eherrpic-lgtm/macropad-v2/README.md

A small macropod featuring 12 programmable keys and 2 rotary encoders. Uses a sandwich design to hold down the pcb and 12 mx switches with a top black plate. 
Keys are programmed to optimise coding and make it easier to access things that can be on the harder side of things to do with a normal keyboard, offering quickly accessible shortcuts for key functions

**Materials for 2 macropads** *add 1 microcontroller and 2 rotary encoders and 2 encoder knobs for 1 more*

| Item | Qty | Description | Vendor | Est. Price
| :--- | :---: | :--- | :--- | :---: |
| Custom PCB | 5 | 2-Layer Macropad PCB | JLCPCB | €1.76 |
| Top Plate | 5 | 1.6mm top plate | JLCPCB | €6.49 |
| Microcontroller | 2 | MOUDLE-SEEDUINO-XIAO | [AliExpress](https://de.aliexpress.com/item/1005008200917480.html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) | €9.39 |
| Switches | 50 | Cherry MX-style mechanical switches | [AliExpress](https://de.aliexpress.com/item/1005012075309061.html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) | €13.99 |
| Rotary Encoders | 4 | EC11 Encoders | [AliExpress](https://de.aliexpress.com/item/1005007644083514.html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) | €3.12 |
| Diodes | 100 | 1N4148 Diodes | [AliExpress](https://de.aliexpress.com/item/1005008905065392.html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) | €1.25 |
| Keycaps & Knobs | 44 | 40x 1u Keycaps + 4x Encoder Knobs | [AliExpress](https://de.aliexpress.com/item/1005007572331245.html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), [AliExpress](https://de.aliexpress.com/item/1005007969022294.html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) | €17.1 |
| Case Hardware | 8 | M2 Brass Standoffs + M2 Screws | [AliExpress](https://de.aliexpress.com/item/1005008512900059.html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), [AliExpress](https://www.aliexpress.com/p/shoppingcart/index.html?spm=a2g0o.home.header.1.32097a8bodTR2p), [AliExpress](https://de.aliexpress.com/item/4000314663724.html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) | €6.37 |
| **Total Estimated Cost** | | *(Excluding Shipping)* | | **59.74** |
| **Shipping costs** | | | | |
| AliExpress | | | AliExpress | €8.68 |
| JLCPCB | | | JLCPCB | €10.61 |
 | **Final Estimated Cost** | | | | **€79.03** |

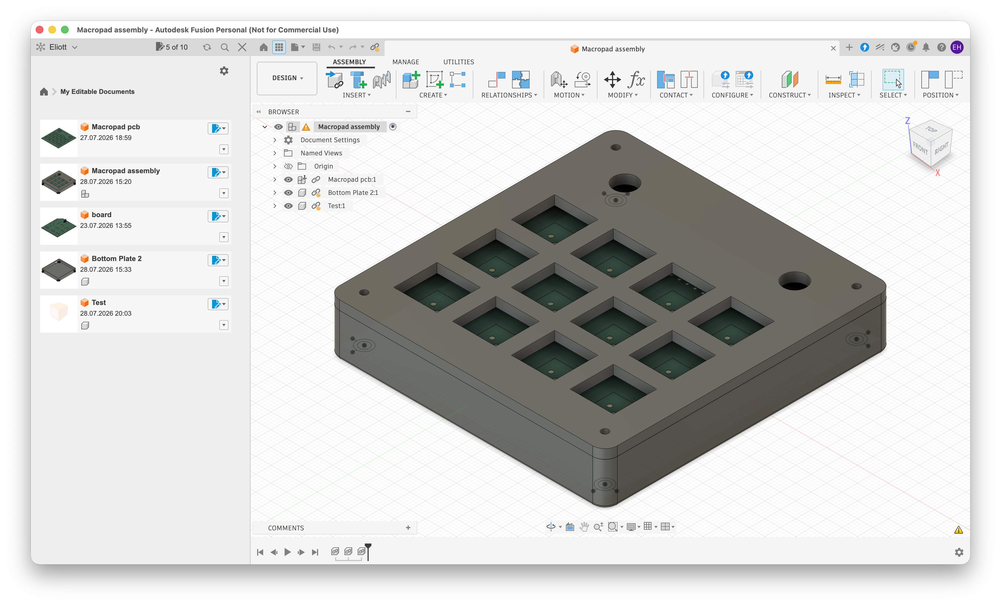
[picture p1: images/Assembly0.png]
3D Render

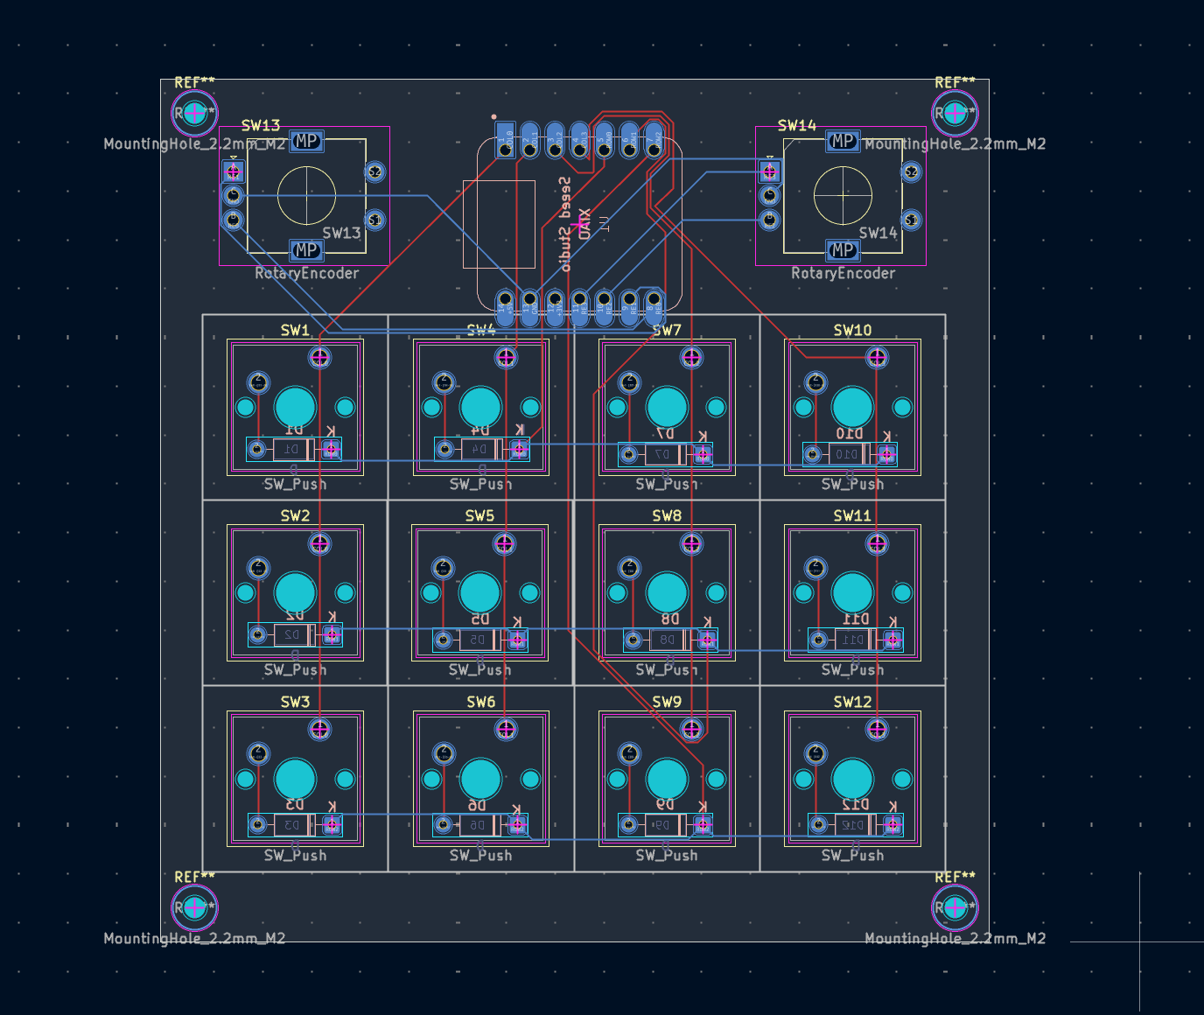
[picture p2: images/PCB.png]
PCB

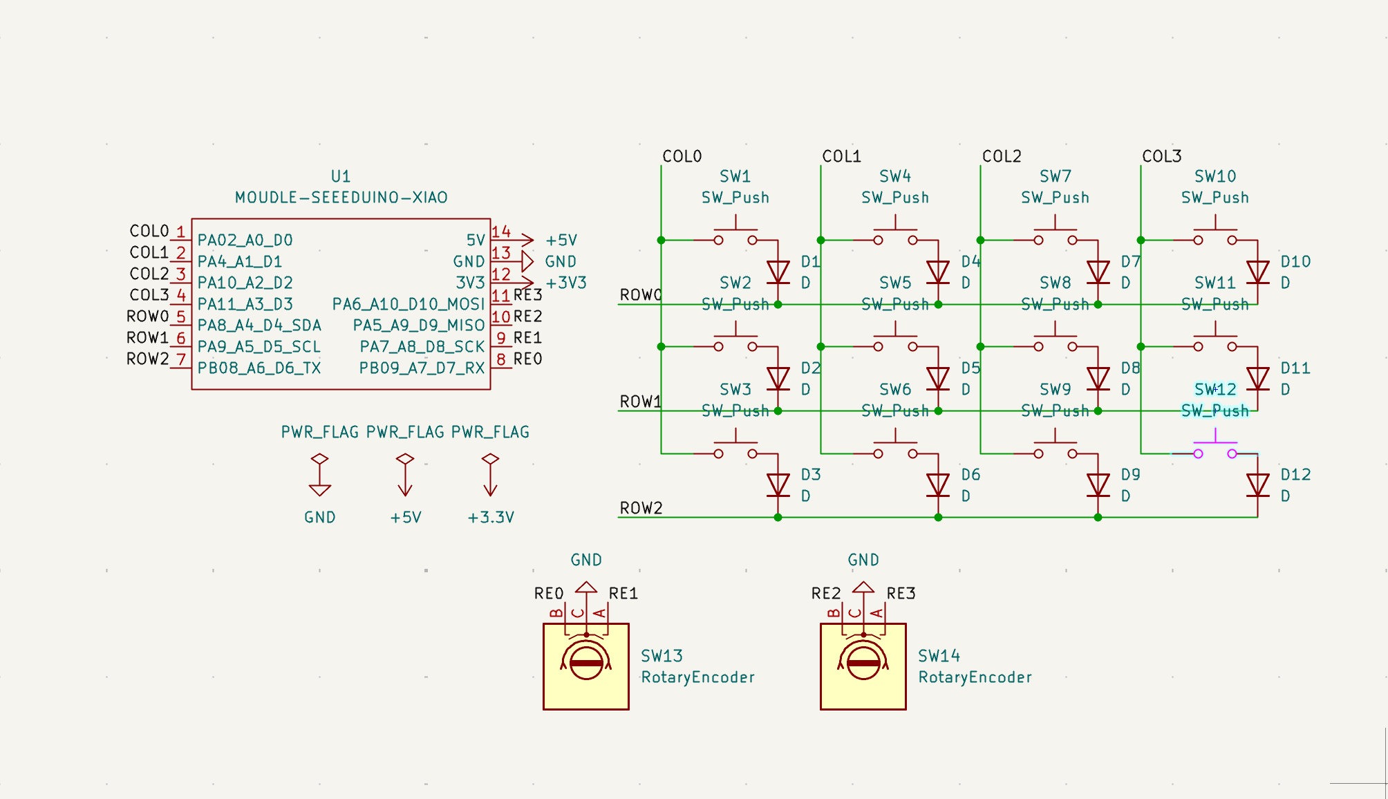
[picture p3: images/Schematic.png]
Schematic
