eherrpic-lgtm/macropad-v2/images/AliExpress.png

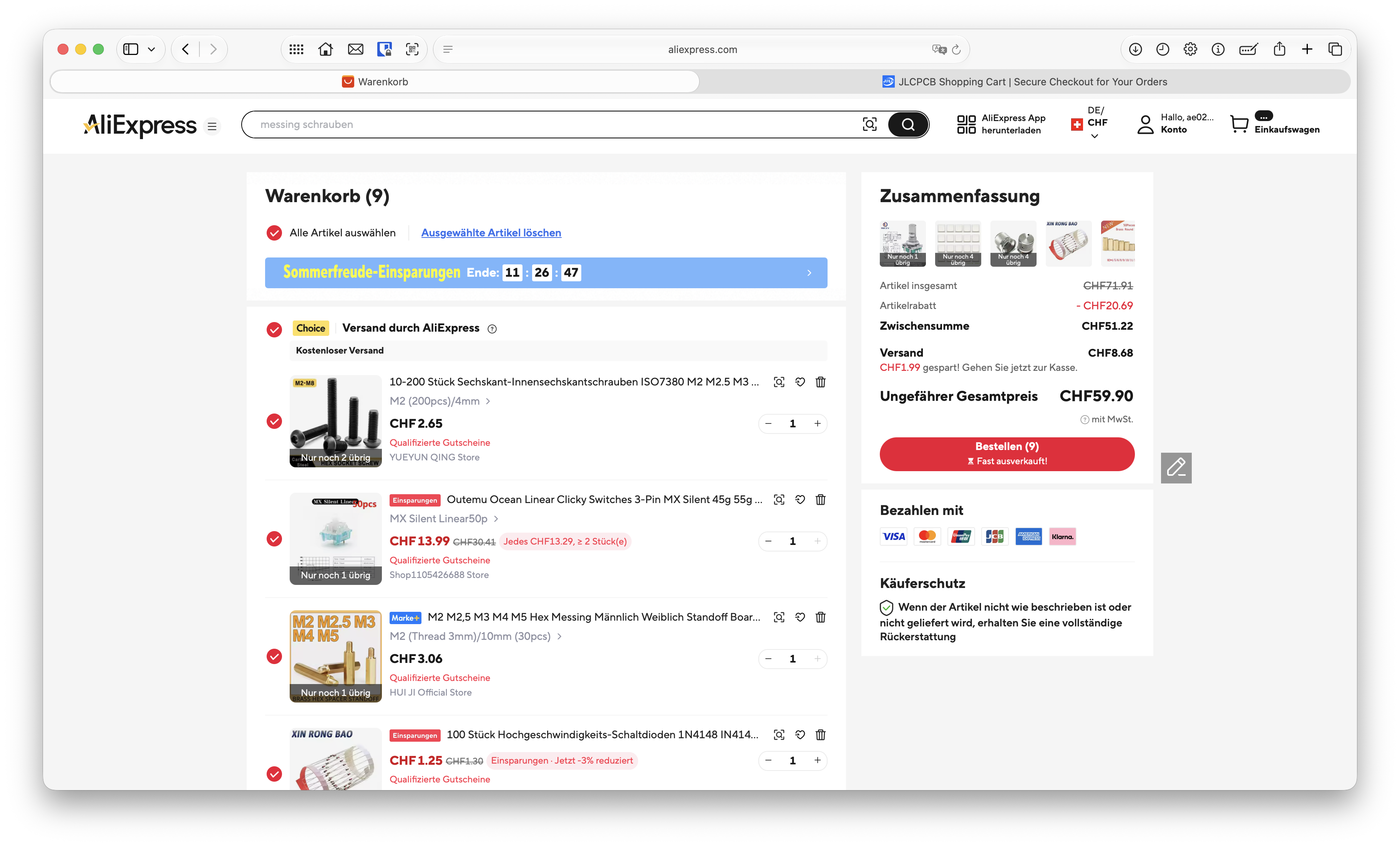
images/AliExpress.png
