eherrpic-lgtm/macropad-v2/images/JLCPCB.png

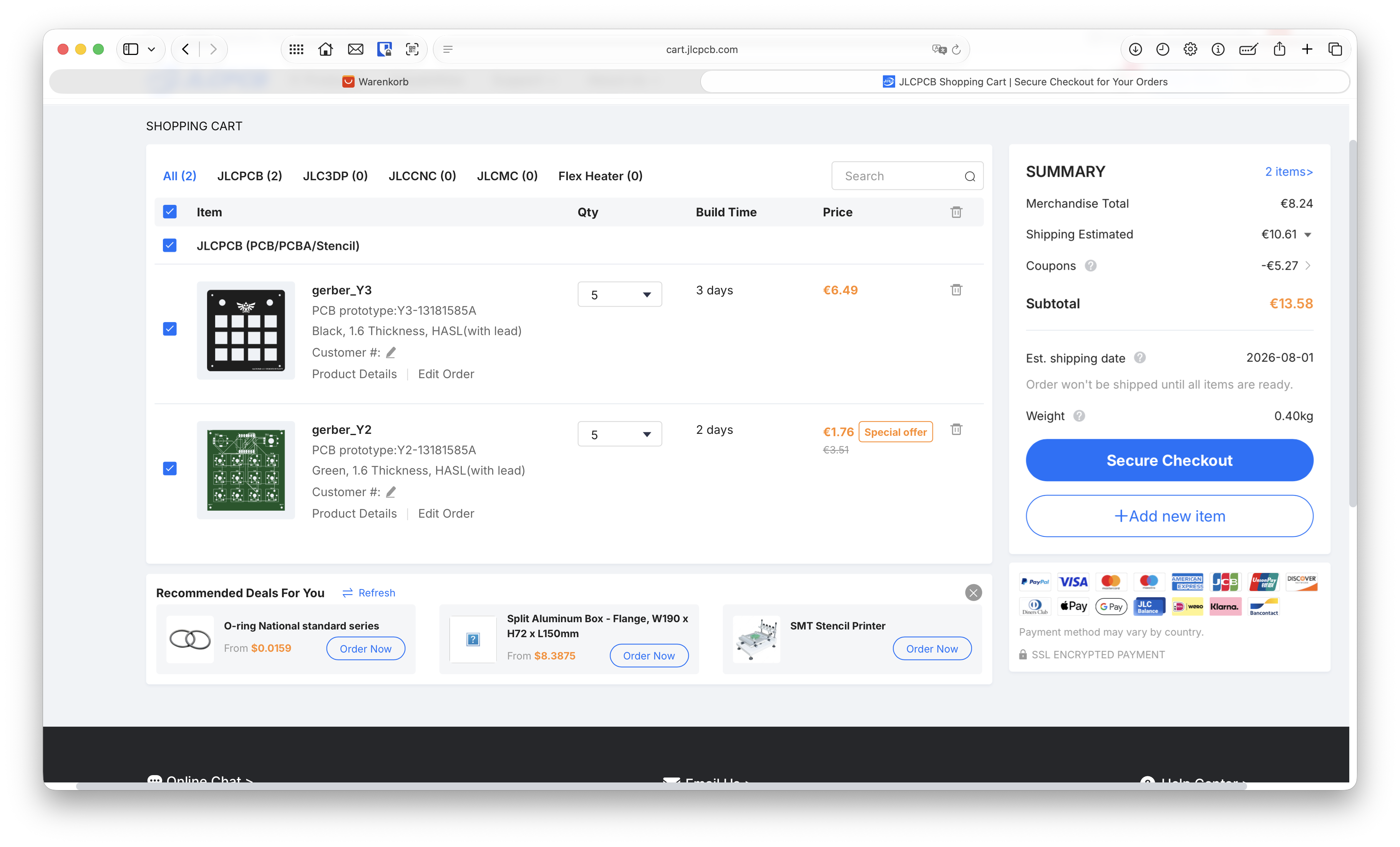
images/JLCPCB.png
