eherrpic-lgtm/macropad-v2/bom.csv

Reference | Qty | Value | DNP | Exclude from BOM | Exclude from Board | Footprint | Datasheet | Description
D1,D2,D3,D4,D5,D6,D7,D8,D9,D10,D11,D12 | 12 | D |  |  |  | Diode_THT:D_DO-35_SOD27_P7.62mm_Horizontal |  | Diode
SW1,SW2,SW3,SW4,SW5,SW6,SW7,SW8,SW9,SW10,SW11,SW12 | 12 | SW_Push |  |  |  | Button_Switch_Keyboard:SW_Cherry_MX_1.00u_PCB |  | Push button switch, generic, two pins
SW13,SW14 | 2 | RotaryEncoder |  |  |  | Rotary_Encoder:RotaryEncoder_Alps_EC11E-Switch_Vertical_H20mm |  | Rotary encoder, dual channel, incremental quadrate outputs
U1 | 1 | MOUDLE-SEEEDUINO-XIAO |  |  |  | footprints:XIAO-Generic-Hybrid-14P-2.54-21X17.8MM
