eherrpic-lgtm/macropad-v2/images/BOM AliExpress.png

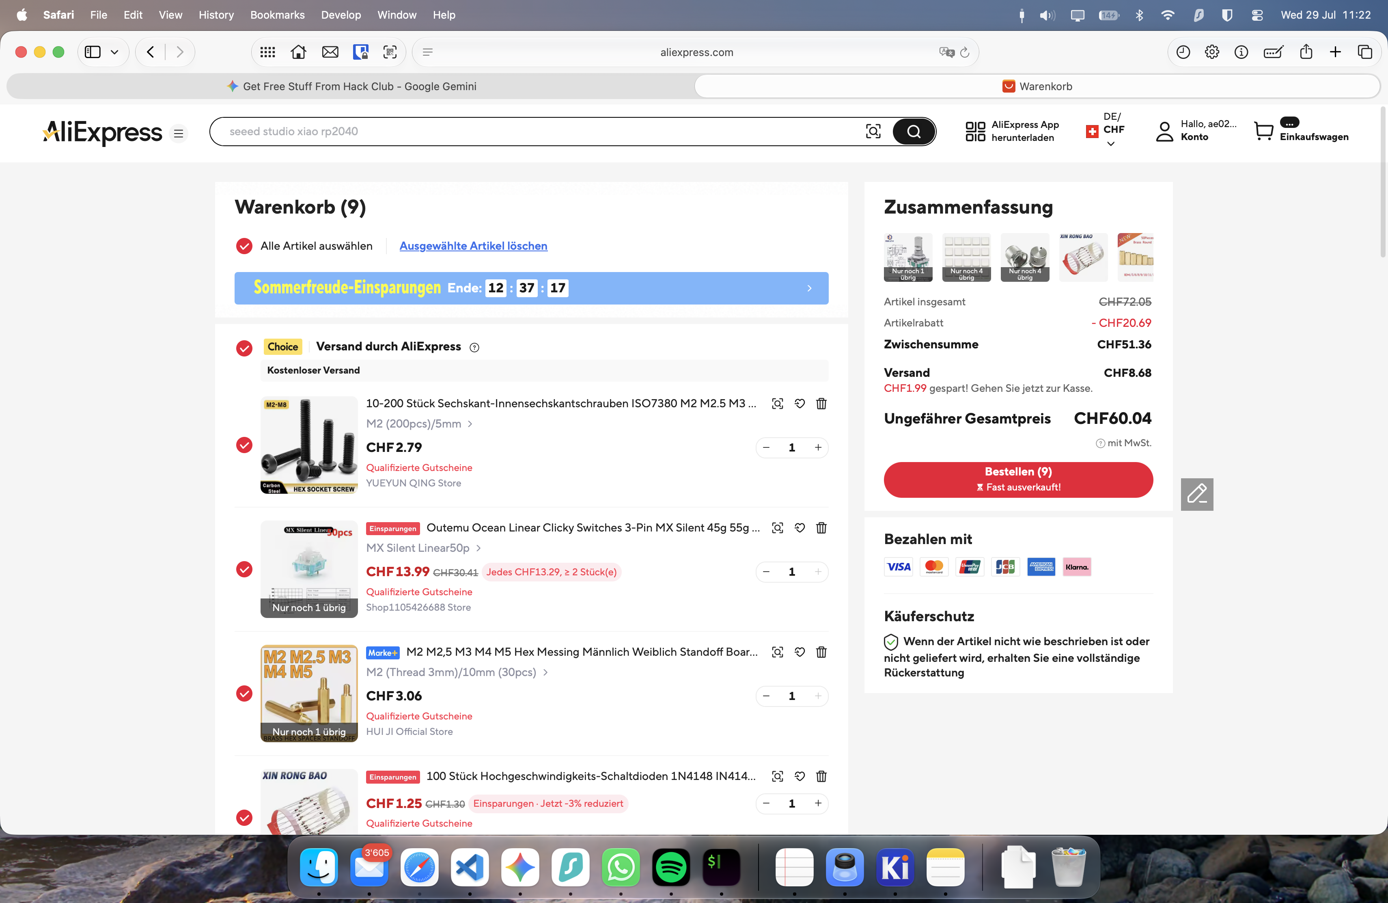
images/BOM AliExpress.png
