eherrpic-lgtm/macropad-v2/CAD/Macropad assembly.step

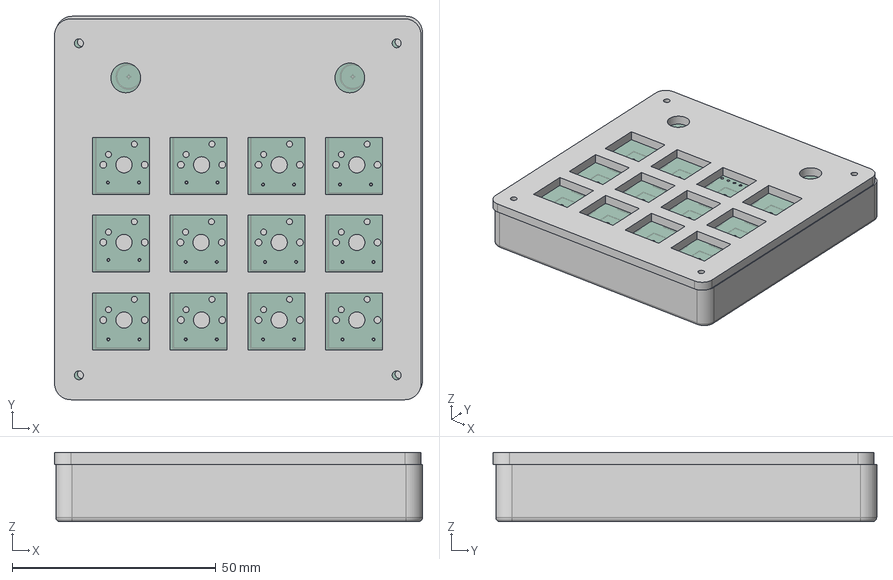
[picture p7: CAD file, 2026-11-11]
CAD/Macropad assembly.step
90.3 x 94.1 x 17.0 mm
D_DO-35_SOD27_P7.62mm_Horizontal_1 x 12
Macropad 2.0_silkscreen
Macropad 2.0_silkscreen_1
Macropad 2.0_soldermask
Macropad 2.0_soldermask_1
Macropad 2.0_PCB
