eherrpic-lgtm/macropad-v2/CAD/Top Plate PCB/Top Plate.dxf

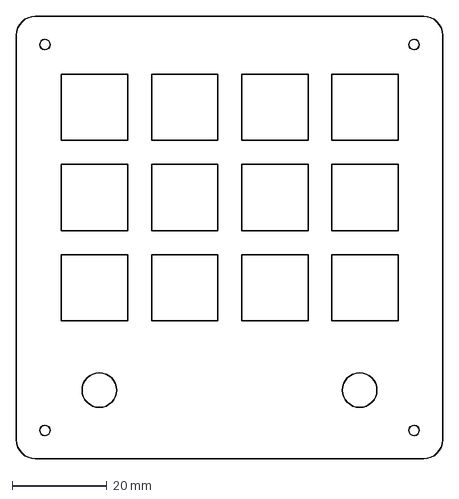
[picture p8: CAD file, 2026-07-28]
CAD/Top Plate PCB/Top Plate.dxf
90.0 x 93.5 mm
