eherrpic-lgtm/macropad-v2/CAD/Macropad pcb.step

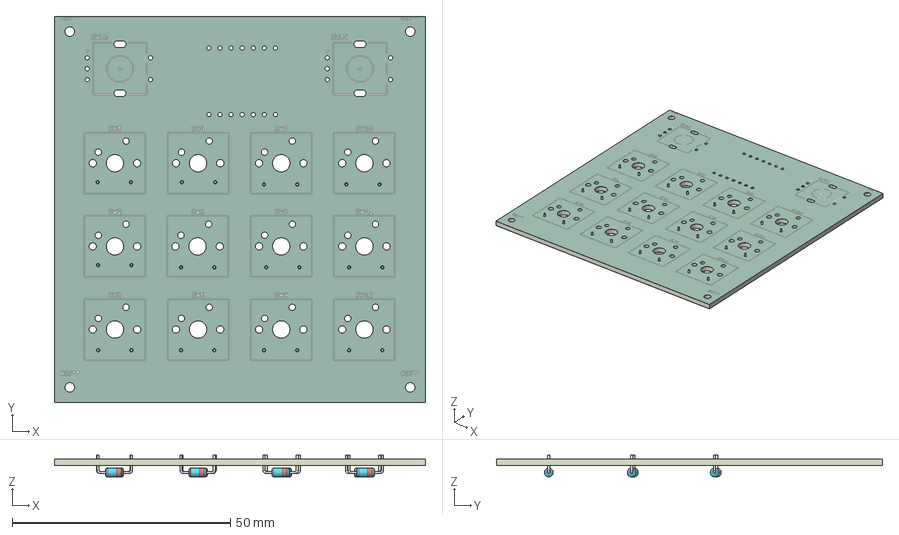
[picture p9: CAD file, 2026-11-11]
CAD/Macropad pcb.step
85.0 x 88.5 x 5.01 mm
D_DO-35_SOD27_P7.62mm_Horizontal_1 x 12
Macropad 2.0_silkscreen
Macropad 2.0_silkscreen_1
Macropad 2.0_soldermask
Macropad 2.0_soldermask_1
Macropad 2.0_PCB
