eherrpic-lgtm/macropad-v2/CAD/Bottom Plate.step

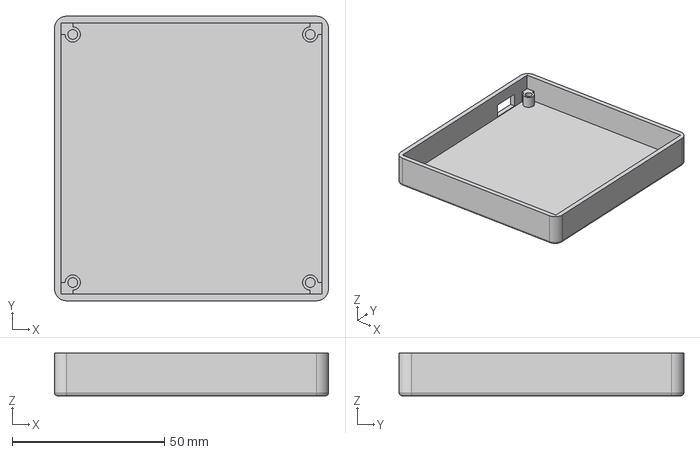
[picture p10: CAD file, 2026-07-28]
CAD/Bottom Plate.step
90.0 x 93.5 x 14.0 mm
