eherrpic-lgtm/macropad-v2/CAD/Top Plate.step

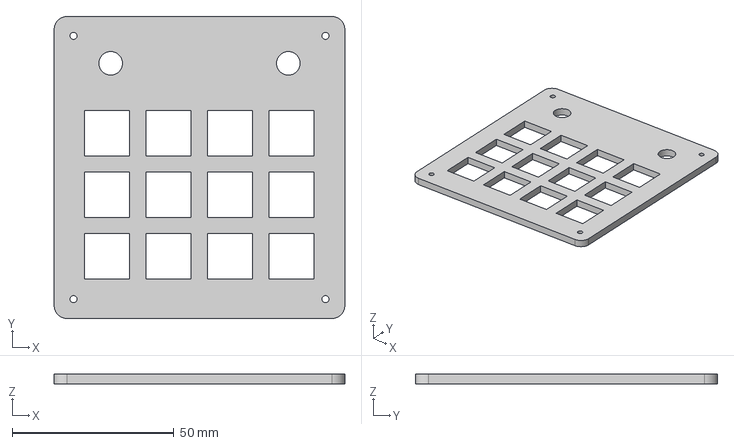
[picture p11: CAD file, 2026-07-28]
CAD/Top Plate.step
90.0 x 93.5 x 3.00 mm
