eherrpic-lgtm/macropad-v2/(list of files, cad)

Other CAD files:
CAD/Bottom Plate 2.f3d
CAD/Bottom Plate.stl
CAD/Macropad pcb.f3d
CAD/Top Plate.f3d
CAD/Top Plate.stl
