eherrpic-lgtm/macropad-v2/PCB/Macropad 2.0.kicad_pcb

## KiCad design PCB/Macropad 2.0.kicad_pcb (2026-07-28)

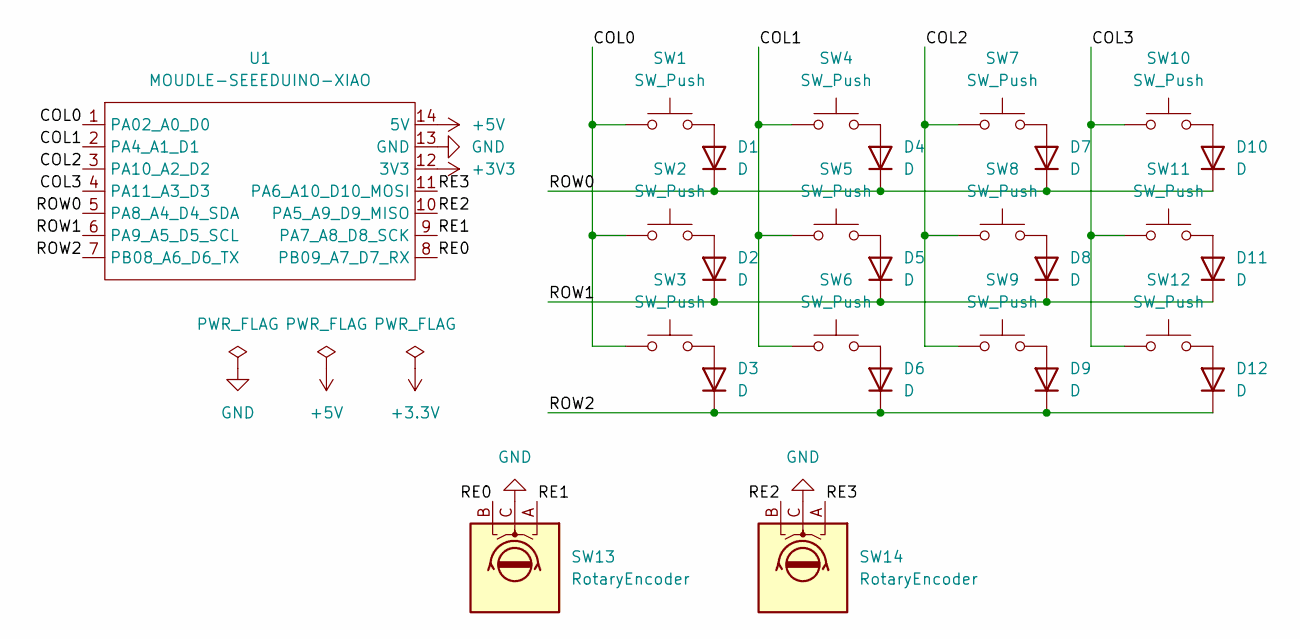
[picture p12: schematic Macropad 2.0.kicad_sch]

Parts:
D1, D2, D3, D4, D5, D6, D7, D8, D9, D10, D11, D12: D; D_DO-35_SOD27_P7.62mm_Horizontal
SW1, SW2, SW3, SW4, SW5, SW6, SW7, SW8, SW9, SW10, SW11, SW12: SW_Push; SW_Cherry_MX_1.00u_PCB
SW13, SW14: RotaryEncoder; RotaryEncoder_Alps_EC11E-Switch_Vertical_H20mm
U1: MOUDLE-SEEEDUINO-XIAO; XIAO-Generic-Hybrid-14P-2.54-21X17.8MM

Connections:
+3V3: U1.12 (3V3)
+5V: U1.14 (5V)
/COL0: SW1.1, SW2.1, SW3.1, U1.1 (PA02_A0_D0)
/COL1: SW4.1, SW5.1, SW6.1, U1.2 (PA4_A1_D1)
/COL2: SW7.1, SW8.1, SW9.1, U1.3 (PA10_A2_D2)
/COL3: SW10.1, SW11.1, SW12.1, U1.4 (PA11_A3_D3)
/RE0: SW13.B, U1.8 (PB09_A7_D7_RX)
/RE1: SW13.A, U1.9 (PA7_A8_D8_SCK)
/RE2: SW14.B, U1.10 (PA5_A9_D9_MISO)
/RE3: SW14.A, U1.11 (PA6_A10_D10_MOSI)
/ROW0: D1.1 (K), D4.1 (K), D7.1 (K), D10.1 (K), U1.5 (PA8_A4_D4_SDA)
/ROW1: D2.1 (K), D5.1 (K), D8.1 (K), D11.1 (K), U1.6 (PA9_A5_D5_SCL)
/ROW2: D3.1 (K), D6.1 (K), D9.1 (K), D12.1 (K), U1.7 (PB08_A6_D6_TX)
GND: SW13.C, SW14.C, U1.13 (GND)
unnamed: D1.2 (A), SW1.2
unnamed: D2.2 (A), SW2.2
unnamed: D3.2 (A), SW3.2
unnamed: D4.2 (A), SW4.2
unnamed: D5.2 (A), SW5.2
unnamed: D6.2 (A), SW6.2
unnamed: D7.2 (A), SW7.2
unnamed: D8.2 (A), SW8.2
unnamed: D9.2 (A), SW9.2
unnamed: D10.2 (A), SW10.2
unnamed: D11.2 (A), SW11.2
unnamed: D12.2 (A), SW12.2

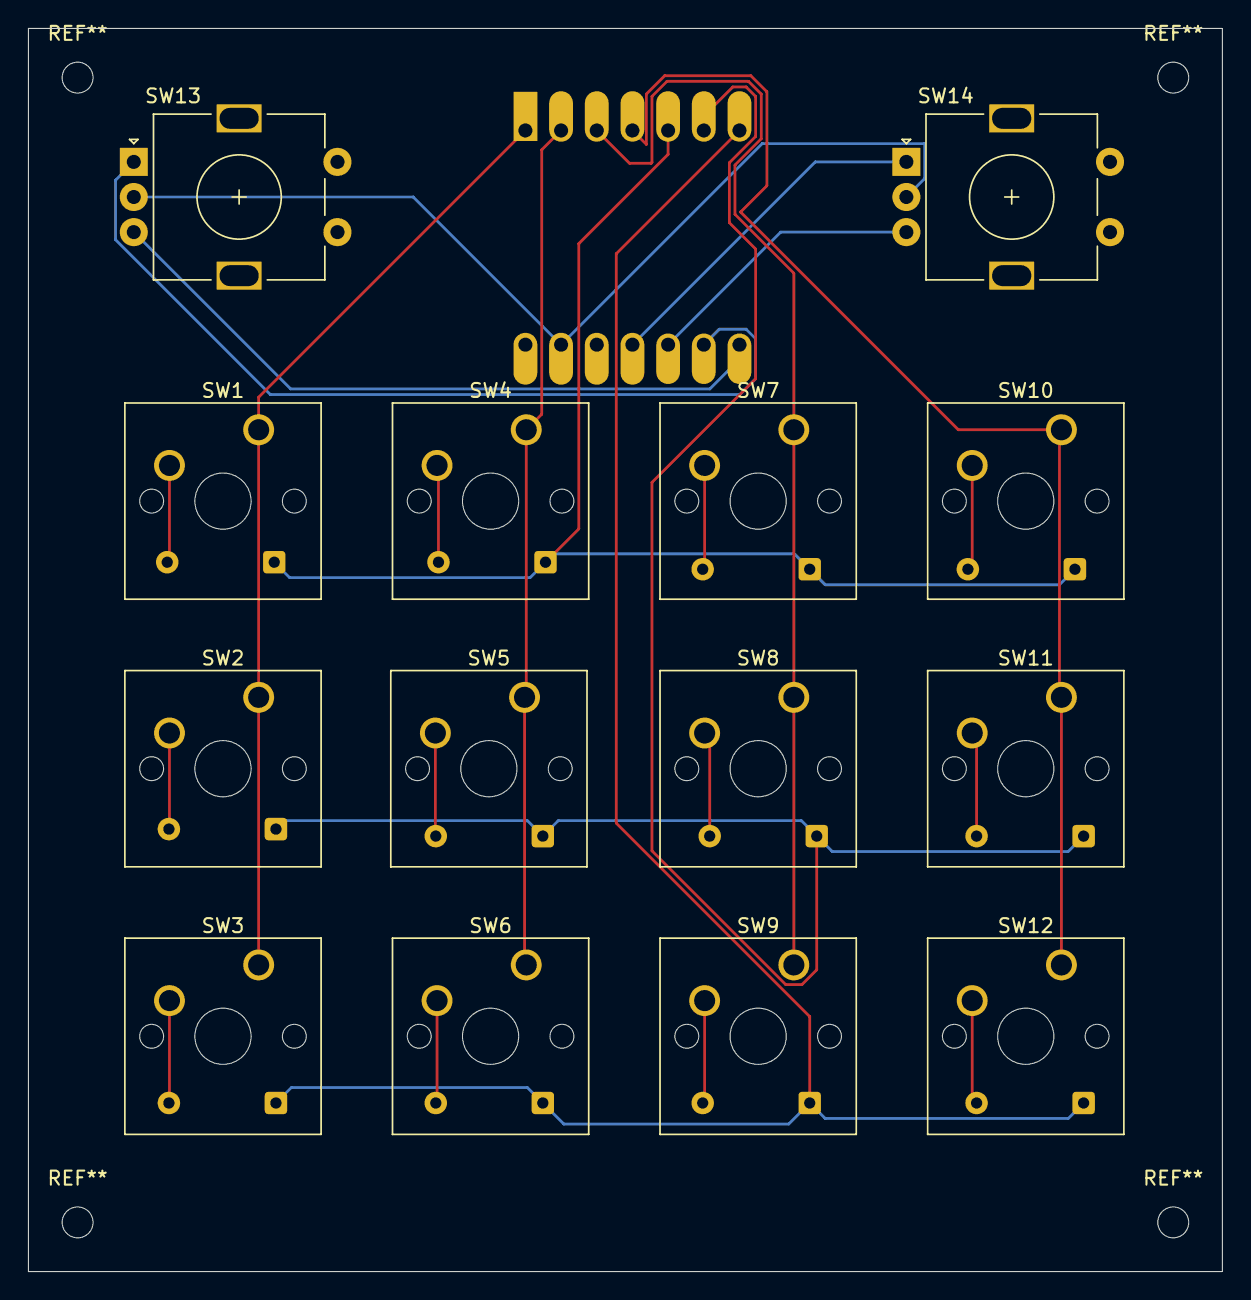
[picture p13: board Macropad 2.0.kicad_pcb from above]

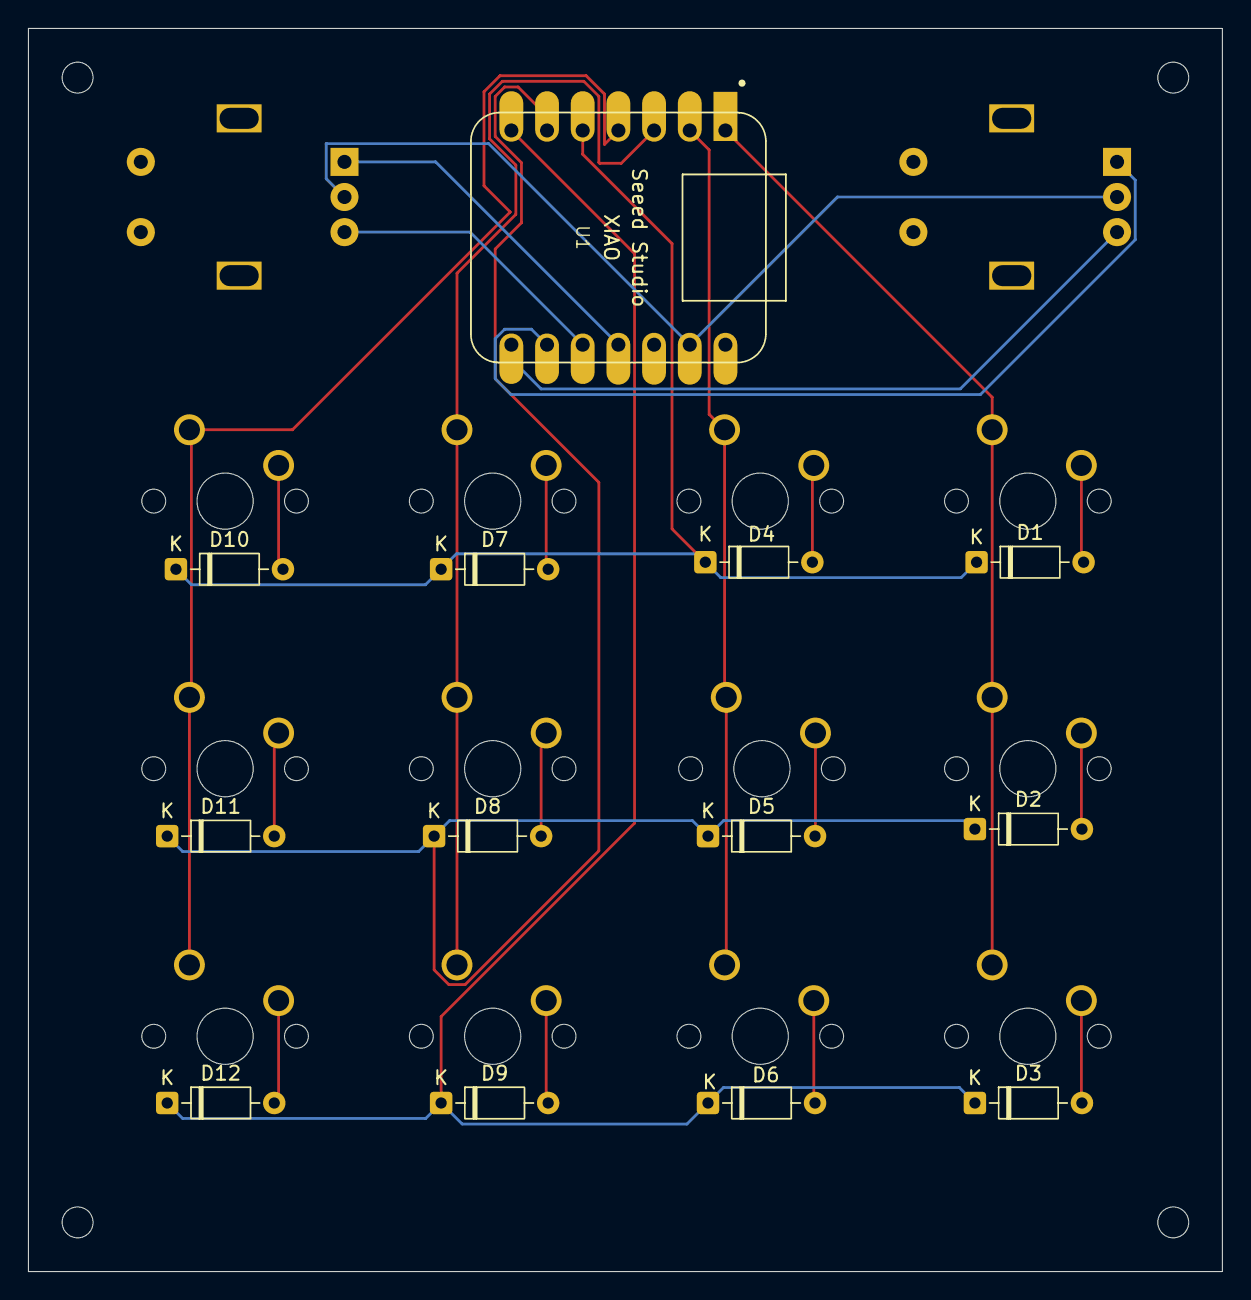
[picture p14: board Macropad 2.0.kicad_pcb from below]

Board: 2 copper layers, 85.0 x 88.5 mm, 27 parts (13 on the bottom side), 24 nets.
