eherrpic-lgtm/macropad-v2/images/Assembly1.png

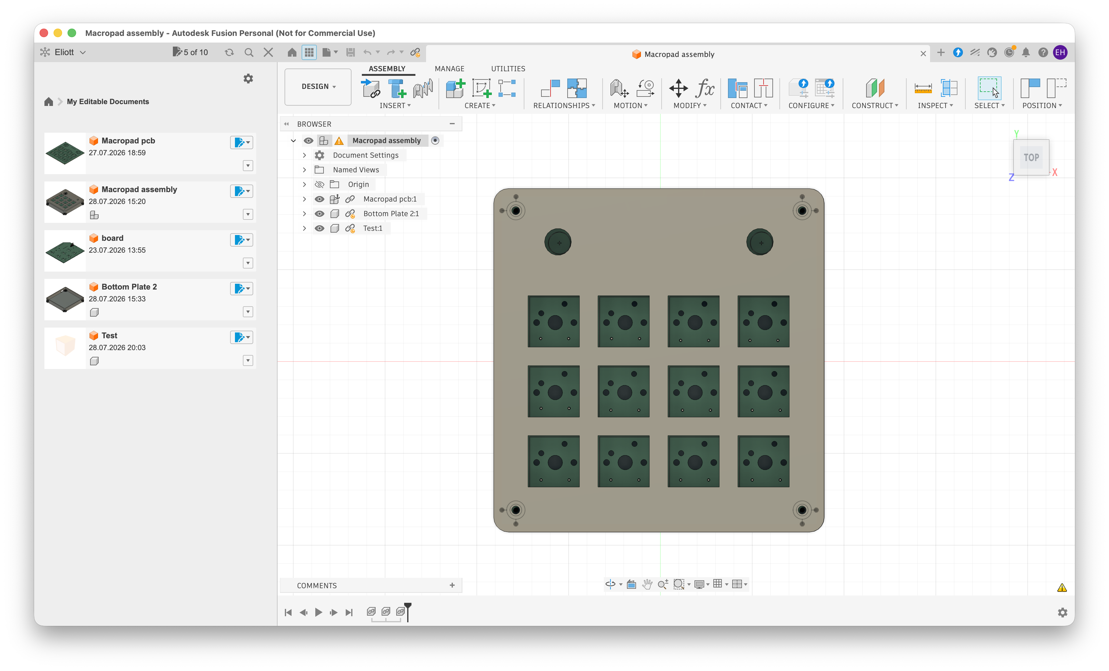
images/Assembly1.png
