eherrpic-lgtm/macropad-v2/images/Assembly2.png

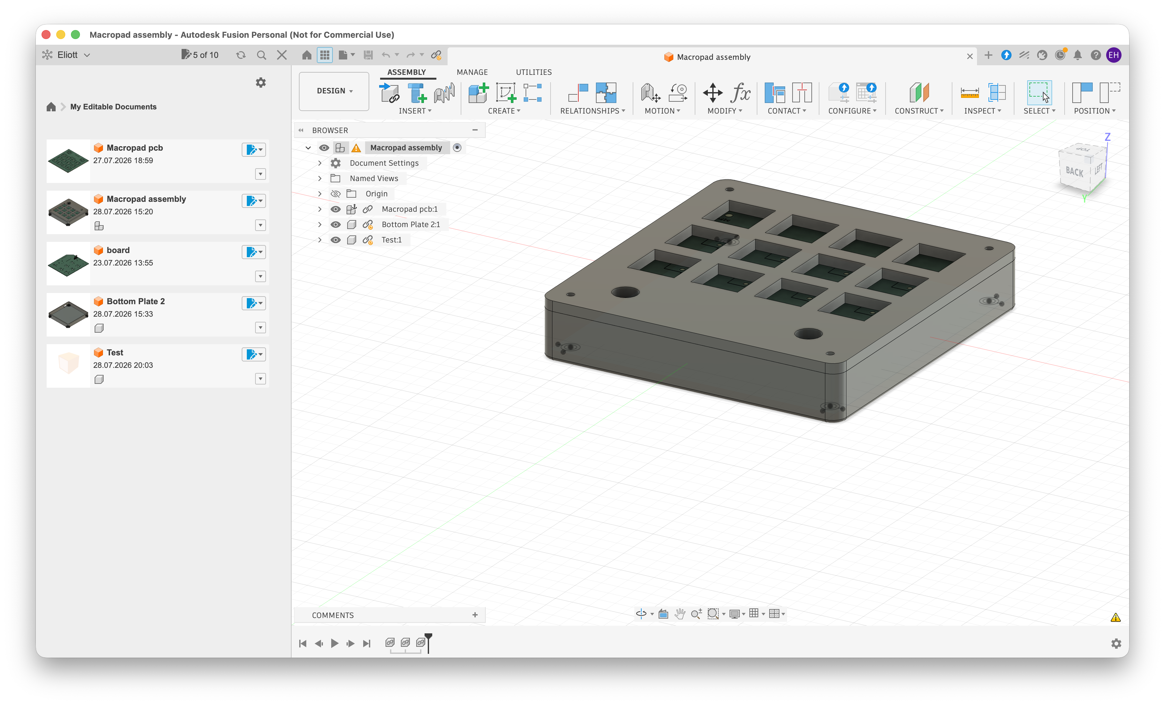
images/Assembly2.png
