eherrpic-lgtm/macropad-v2/(commit log)

2026-07-28 Fixed gerber.zip
2026-07-28 Final gerbers fix
2026-07-28 Finally fixed gerbers, functional
2026-07-29 Final touches, completed BOM and top plate PCB design
    [Top Plate-B_Cu.gbr, Top Plate-B_Mask.gbr, Top Plate-B_Paste.gbr, Top Plate-B_Silkscreen.gbr, Top Plate-Edge_Cuts.gbr, Top Plate-F_Cu.gbr, Top Plate-F_Mask.gbr, Top Plate-F_Paste.gbr]
2026-07-29 Revise materials for 2 macropads with extra components
    Updated materials list for macropads to include additional components.
2026-07-29 Update README with macropod description and materials
    Added a brief description of the macropod and materials needed for assembly.
2026-07-29 Added .csv
    [Macropad 2.0.csv]
2026-07-29 Add vendor links to components in README
    Updated vendor links for components in the BOM.
2026-07-29 Rename Macropad 2.0.csv to bom.csv
    [bom.csv]
2026-11-09 Update JOURNAL.md with new entries and images
    Added images and updated entries for schematic design, PCB layout, chassis design, and firmware setup.
2026-11-11 Removed duplicate files
    [Bottom Plate 2.f3d, Macropad assembly.step, Macropad pcb.f3d, Top Plate.f3d]
2026-11-11 Create Macropad assembly.step
    [Macropad assembly.step]
2026-11-11 Removed duplicate Macropad assembly files
    [Macropad assembly.step]
